maasijam/MCVGO/Hardware/Schematic_MCVGO.pdf

1

2

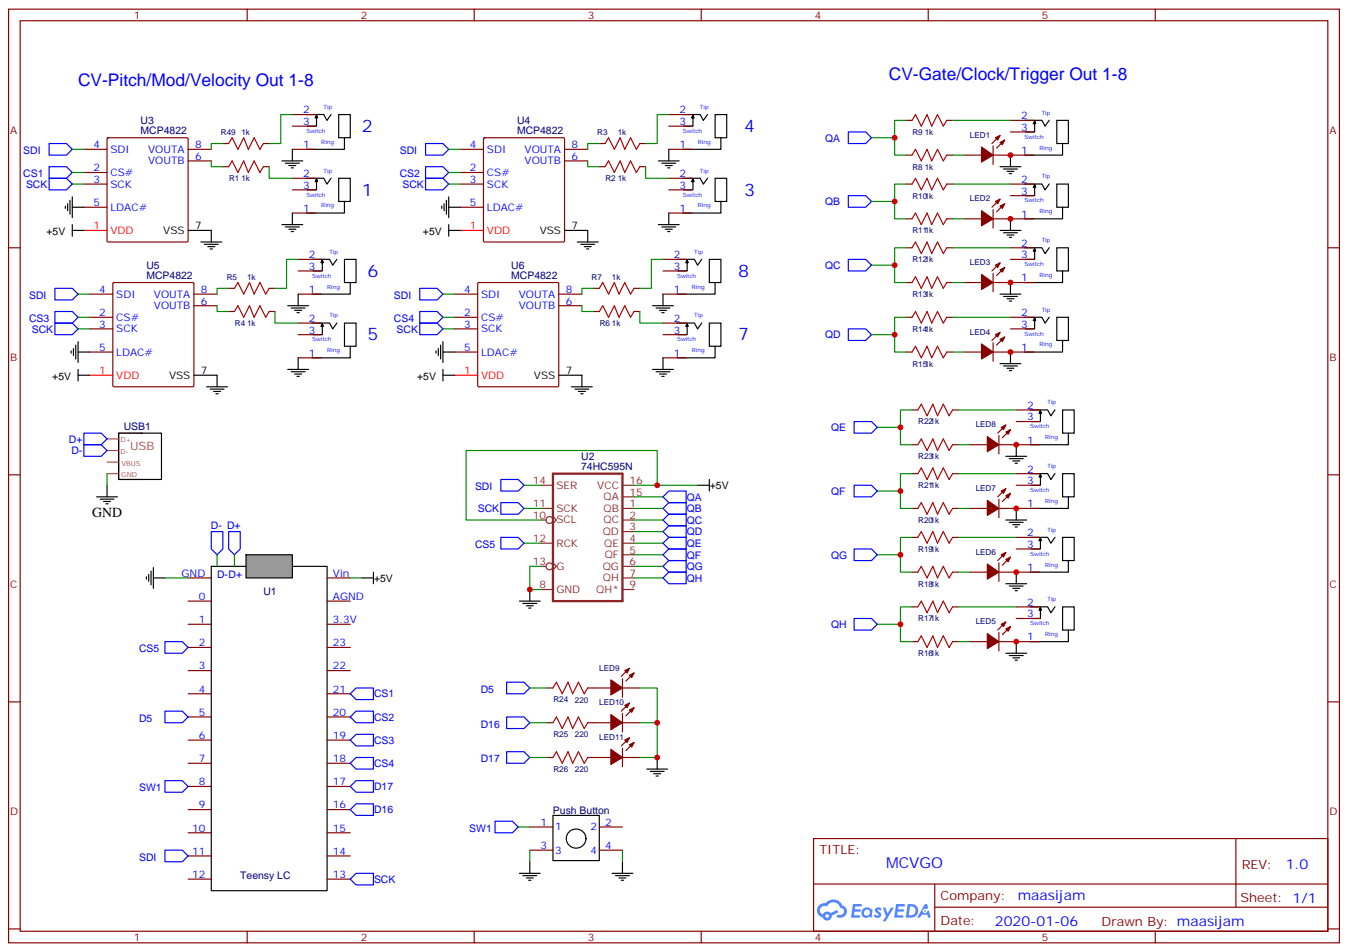
[picture p5: page 1]
