maasijam/MCVGO/(commit log)

2020-01-30 moved files to subfolder
    [BOM_maasijam_mcvgo.csv]
2020-02-08 added gerber files and clean up code
2023-08-19 Update README.md
    Teensy 4 usb d+/d- pins on the bottom side have to be checked
2023-08-19 Revert "Update Schematic_MCVGO.pdf"
    This reverts commit 1bc74a24608ebf8aa890233898da0e4ae1f58009.
2023-08-19 Revert "Update BOM_maasijam_mcvgo.csv"
    This reverts commit 3e13b3f840dce54c00bca0acf8d2e8c1889124e6.
    [BOM_maasijam_mcvgo.csv]
